KJH5001212/ad5941/discrete-potentiostat/hardware/kicad/discrete-potentiostat.kicad_pcb

## KiCad design discrete-potentiostat/hardware/kicad/discrete-potentiostat.kicad_pcb (2026-07-12, last stored version)

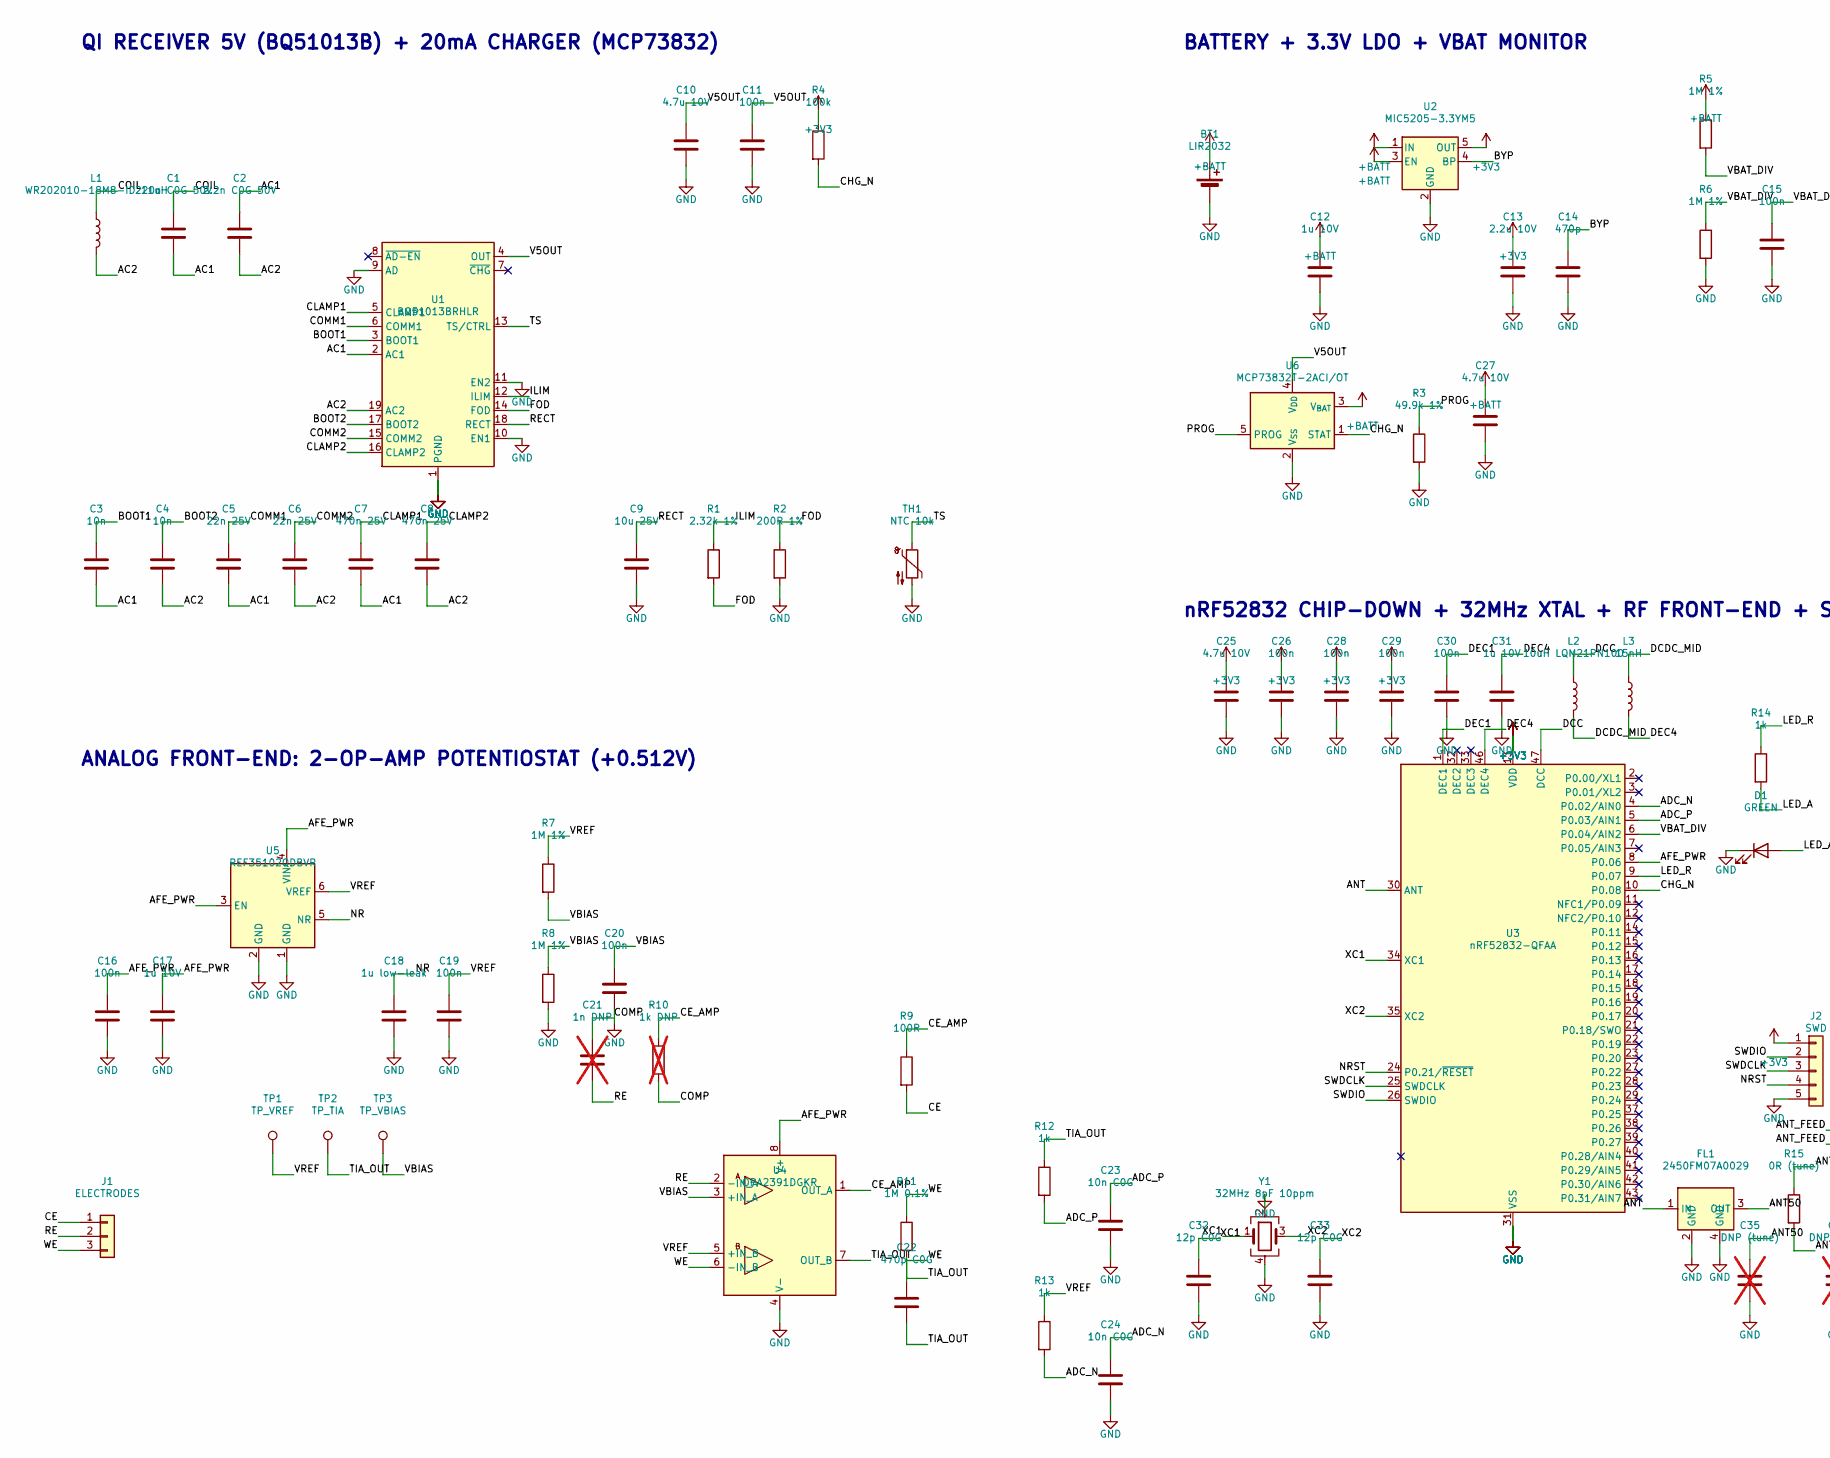
[picture p1: schematic discrete-potentiostat.kicad_sch, Discrete Potentiostat - wireless 3-electrode chronoamperome…, part in row 1, column 1]

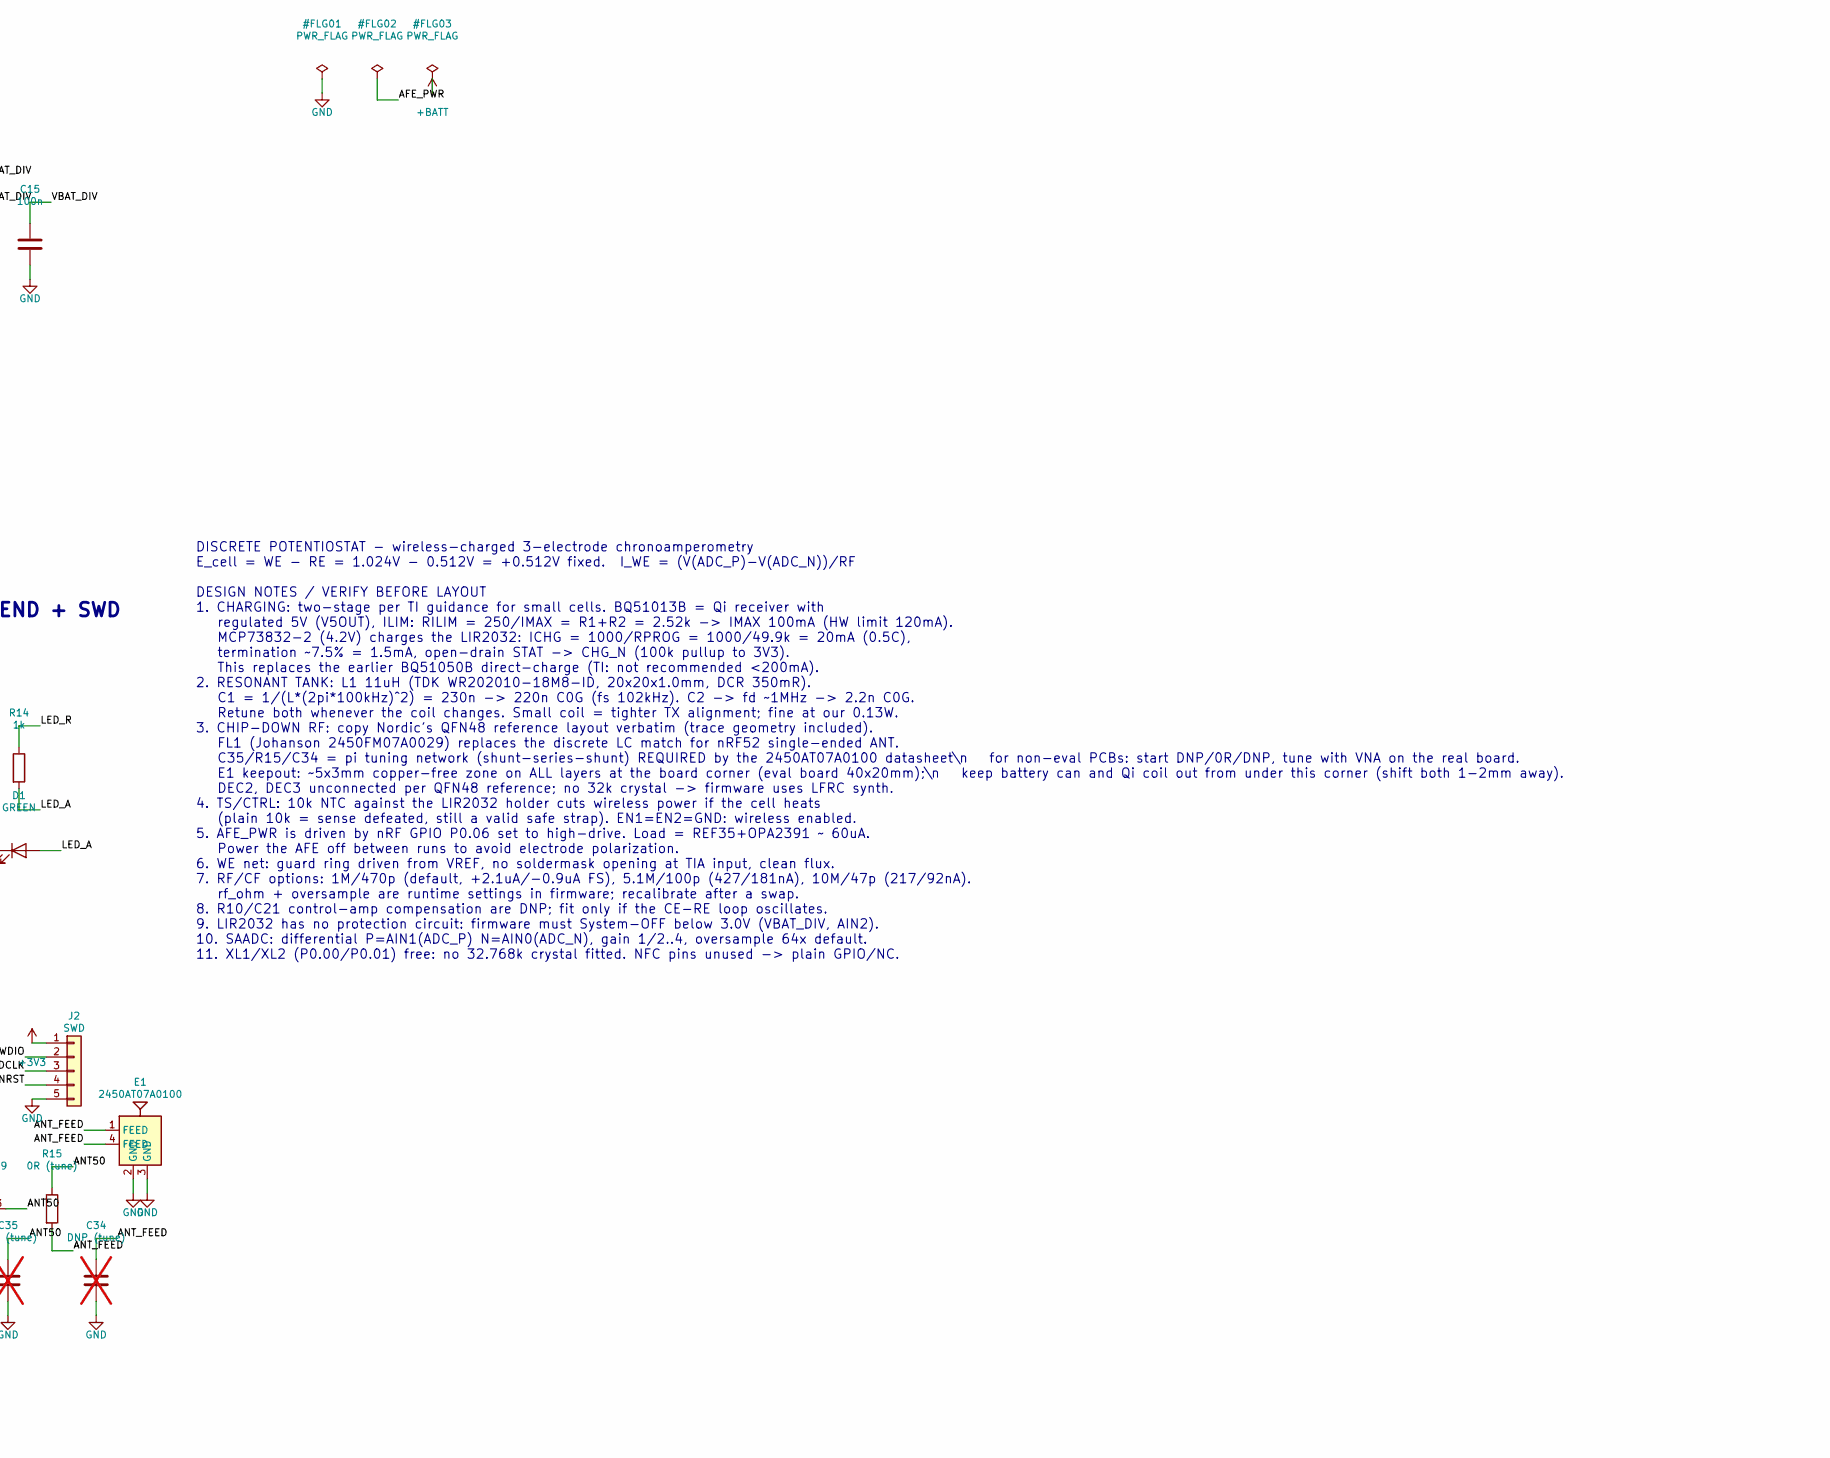
[picture p2: schematic discrete-potentiostat.kicad_sch, Discrete Potentiostat - wireless 3-electrode chronoamperome…, part in row 1, column 2]

Parts:
BT1: LIR2032; BatteryHolder_Keystone_3034_1x20mm
C1: 220n C0G 50V; C_1210_3225Metric
C2: 2.2n C0G 50V; C_0603_1608Metric
C3, C4: 10n; C_0402_1005Metric
C5, C6: 22n 25V; C_0402_1005Metric
C7, C8: 470n 25V; C_0603_1608Metric
C9: 10u 25V; C_0805_2012Metric
C10, C25, C27: 4.7u 10V; C_0603_1608Metric
C11, C15, C16, C19, C20, C26, C28, C29, C30: 100n; C_0402_1005Metric
C12, C17, C31: 1u 10V; C_0402_1005Metric
C13: 2.2u 10V; C_0603_1608Metric
C14: 470p; C_0402_1005Metric
C18: 1u low-leak; C_0603_1608Metric
C21: 1n DNP; C_0402_1005Metric; not fitted
C22: 470p C0G; C_0603_1608Metric
C23, C24: 10n C0G; C_0402_1005Metric
C32, C33: 12p C0G; C_0402_1005Metric
C34, C35: DNP (tune); C_0402_1005Metric; not fitted
D1: GREEN; LED_0603_1608Metric
E1: 2450AT07A0100; Johanson_2450AT07A0100
FL1: 2450FM07A0029; Johanson_0402_4pin
J1: ELECTRODES; SolderPads_1x03_D1.0mm
J2: SWD; SolderPads_1x05_D1.0mm
L1: WR202010-18M8-ID 11uH; TDK_WR202010
L2: 10uH LQM21PN100; L_0805_2012Metric
L3: 15nH; L_0402_1005Metric
R1: 2.32k 1%; R_0402_1005Metric
R2: 200R 1%; R_0402_1005Metric
R3: 49.9k 1%; R_0402_1005Metric
R4: 100k; R_0402_1005Metric
R5, R6, R7, R8: 1M 1%; R_0402_1005Metric
R9: 100R; R_0402_1005Metric
R10: 1k DNP; R_0402_1005Metric; not fitted
R11: 1M 0.1%; R_0603_1608Metric
R12, R13, R14: 1k; R_0402_1005Metric
R15: 0R (tune); R_0402_1005Metric
TH1: NTC 10k; R_0402_1005Metric
TP1: TP_VREF; TestPoint_Pad_D1.5mm
TP2: TP_TIA; TestPoint_Pad_D1.5mm
TP3: TP_VBIAS; TestPoint_Pad_D1.5mm
U1: BQ51013BRHLR; Texas_VQFN-RHL-20
U2: MIC5205-3.3YM5; SOT-23-5
U3: nRF52832-QFAA; QFN-48-1EP_6x6mm_P0.4mm_EP4.6x4.6mm
U4: OPA2391DGKR; VSSOP-8_3.0x3.0mm_P0.65mm
U5: REF35102QDBVR; SOT-23-6
U6: MCP73832T-2ACI/OT; SOT-23-5
Y1: 32MHz 8pF 10ppm; Crystal_SMD_3225-4Pin_3.2x2.5mm

Connections:
+3V3: C13.1, C25.1, C26.1, C28.1, C29.1, J2.1, R4.1, U2.5 (OUT), U3.13 (VDD), U3.36 (VDD), U3.48 (VDD)
+BATT: BT1.1 (+), C12.1, C27.1, R5.1, U2.1 (IN), U2.3 (EN), U6.3 (V_{BAT})
AC1: C1.2, C2.1, C3.2, C5.2, C7.2, U1.2 (AC1)
AC2: C2.2, C4.2, C6.2, C8.2, L1.2, U1.19 (AC2)
ADC_N: C24.1, R13.2, U3.4 (P0.02/AIN0)
ADC_P: C23.1, R12.2, U3.5 (P0.03/AIN1)
AFE_PWR: C16.1, C17.1, U3.8 (P0.06), U4.8 (V+), U5.3 (EN), U5.4 (VIN)
ANT: FL1.1 (IN), U3.30 (ANT)
ANT50: C35.1, FL1.3 (OUT), R15.1
ANT_FEED: C34.1, E1.1 (FEED), E1.4 (FEED), R15.2
BOOT1: C3.1, U1.3 (BOOT1)
BOOT2: C4.1, U1.17 (BOOT2)
BYP: C14.1, U2.4 (BP)
CE: J1.1, R9.2
CE_AMP: R9.1, R10.1, U4.1 (OUT_A)
CHG_N: R4.2, U3.10 (P0.08), U6.1 (STAT)
CLAMP1: C7.1, U1.5 (CLAMP1)
CLAMP2: C8.1, U1.16 (CLAMP2)
COIL: C1.1, L1.1
COMM1: C5.1, U1.6 (COMM1)
COMM2: C6.1, U1.15 (COMM2)
COMP: C21.1, R10.2
DCC: L2.1, U3.47 (DCC)
DCDC_MID: L2.2, L3.1
DEC1: C30.1, U3.1 (DEC1)
DEC4: C31.1, L3.2, U3.46 (DEC4)
FOD: R1.2, R2.1, U1.14 (FOD)
GND: BT1.2 (-), C9.2, C10.2, C11.2, C12.2, C13.2, C14.2, C15.2, C16.2, C17.2, C18.2, C19.2, C20.2, C23.2, C24.2, C25.2, C26.2, C27.2, C28.2, C29.2, C30.2, C31.2, C32.2, C33.2, C34.2, C35.2, D1.1 (K), E1.2 (GND), E1.3 (GND), FL1.2 (GND), FL1.4 (GND), J2.5, R2.2, R3.2, R6.2, R8.2, TH1.2, U1.1 (PGND), U1.9 (AD), U1.10 (EN1), U1.11 (EN2), U1.20 (PGND), U1.21 (PGND), U2.2 (GND), U3.31 (VSS), U3.45 (VSS), U3.49 (VSS), U4.4 (V-), U5.1 (GND), U5.2 (GND), U6.2 (V_{SS}), Y1.2, Y1.4
ILIM: R1.1, U1.12 (ILIM)
LED_A: D1.2 (A), R14.2
LED_R: R14.1, U3.9 (P0.07)
NR: C18.1, U5.5 (NR)
NRST: J2.4, U3.24 (P0.21/~RESET)
PROG: R3.1, U6.5 (PROG)
RE: C21.2, J1.2, U4.2 (-IN_A)
RECT: C9.1, U1.18 (RECT)
SWDCLK: J2.3, U3.25 (SWDCLK)
SWDIO: J2.2, U3.26 (SWDIO)
TIA_OUT: C22.2, R11.2, R12.1, TP2.1, U4.7 (OUT_B)
TS: TH1.1, U1.13 (TS/CTRL)
V5OUT: C10.1, C11.1, U1.4 (OUT), U6.4 (V_{DD})
VBAT_DIV: C15.1, R5.2, R6.1, U3.6 (P0.04/AIN2)
VBIAS: C20.1, R7.2, R8.1, TP3.1, U4.3 (+IN_A)
VREF: C19.1, R7.1, R13.1, TP1.1, U4.5 (+IN_B), U5.6 (VREF)
WE: C22.1, J1.3, R11.1, U4.6 (-IN_B)
XC1: C32.1, U3.34 (XC1), Y1.1
XC2: C33.1, U3.35 (XC2), Y1.3

Notes on the sheet:
DISCRETE POTENTIOSTAT - wireless-charged 3-electrode chronoamperometry E_cell = WE - RE = 1.024V - 0.512V = +0.512V fixed. I_WE = (V(ADC_P)-V(ADC_N))/RF DESIGN NOTES / VERIFY BEFORE LAYOUT 1. CHARGING: two-stage per TI guidance for small cells. BQ51013B = Qi receiver with regulated 5V (V5OUT), ILIM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
QI RECEIVER 5V (BQ51013B) + 20mA CHARGER (MCP73832)
BATTERY + 3.3V LDO + VBAT MONITOR
ANALOG FRONT-END: 2-OP-AMP POTENTIOSTAT (+0.512V)
nRF52832 CHIP-DOWN + 32MHz XTAL + RF FRONT-END + SWD

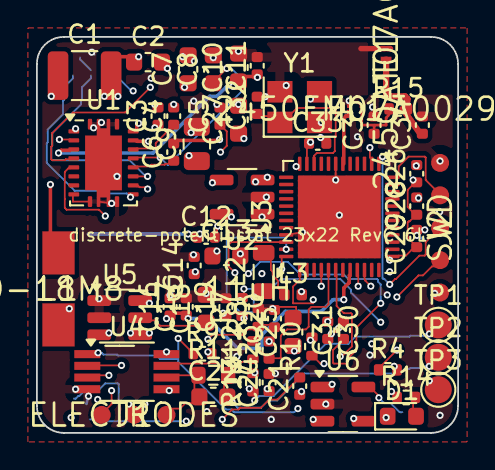
[picture p3: board discrete-potentiostat.kicad_pcb from above]

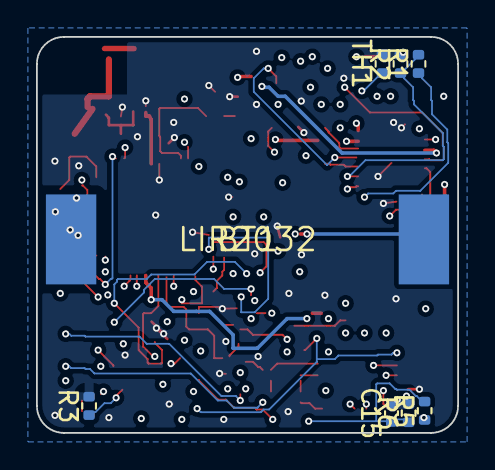
[picture p4: board discrete-potentiostat.kicad_pcb from below]

Board: 6 copper layers, 23.4 x 22.0 mm, 70 parts (8 on the bottom side), 47 nets.
