KJH5001212/ad5941/(commit log)

2026-07-10 Initial commit: AD5941 potentiostat firmware + Android app
    - firmware/: nRF52832 Zephyr chronoamperometry @ +0.5V, autorange (512k..110R),
    run modes (continuous/timed/cycle), BLE NUS JSON protocol, lossless ACK-based
    offline buffer, power-aware connection interval. Vendored ADI AD5940 lib.
    - android-app/: Kotlin controller - parameter form, current-vs-time graph,
    CSV record/export, seq-dedup + ACK lossless sync.
2026-07-10 App-controlled potentiostat: reliable BLE writes + firmware clean-up
    Android app:
    - Reliable command delivery: serialized GATT write queue + fast connection-interval
    request on connect (fixes data arriving in a delayed ~10s batch)
    - GATT cache refresh on connect, RX characteristic fallback
    - Robust percentile auto-scale for the current-vs-time plot
    - On-screen BLE diagnostics (notif/samp/tx/mtu)
    Firmware (main.c):
    - Reverted experimental start/connection-interval changes to the simple, low-power
    path; idle uses the slow (power-saving) connection interval
    - Diagnostic J-Link scripts for SWD state inspection
    Note: the board must run standalone (battery) — a connected debug probe loads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
    [main.c]
2026-07-10 Reliable repeated start/stop + responsiveness
    Firmware (ad5941_pstat/src/main.c):
    - meas_thread re-inits the AFE only when a light ADIID re-read shows it dead,
    instead of an unconditional HWReset every start (avoids re-settle latency and
    brown-out from repeated resets, while still recovering a dead AFE on start).
    - Constant fast BLE interval (idle = fast 30-50ms). The 1.5s idle interval made
    the next start's command/status slow (1.3-3s) and risked idle supervision
    timeout disconnects (status=8).
    - Boot-time AFE init retry (5x).
    App (EmgPle52):
    - userStopping guard: a stale run status right after Stop no longer flips the
    button back to Stop (the 2nd Start was actually sending stop)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
    [main.c]
2026-07-10 Add discrete-potentiostat design: OPA2391 dual-amp CA device with Qi charging
    New folder for the miniature 3-electrode chronoamperometry device built
    without the AD5941: OPA2391 (control amp + TIA), REF35102 1.024V reference,
    nRF52832 SAADC differential measurement, MIC5205-3.3, BQ51050B Qi receiver
    charging a LIR2032 coin cell.
    - README: part roles and signal chain
    - hardware/design.md: bias network (+0.4995V), TIA sizing, SAADC gain
    ranging, charge-current/TS setup, power budget, protection
    - hardware/bom.md: full BOM including precision passives
    - firmware-plan.md: port plan reusing existing BLE/buffering firmware
    Claude-Session: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
2026-07-10 Simplify bias to 1:1 divider (+0.512V), justify RF=1M + oversampling for 1nA
    - Bias: exact 0.5V not required, so use matched 1.00M/1.00M divider ->
    E = +0.512V fixed; 1% resistors suffice
    - Add RF trade-off analysis (1M + 64x oversampling vs 10M): both meet the
    1nA resolution requirement, 1M chosen for uA-range coverage; keep 10M
    swap footprint for sensors confirmed under ~200nA
    - Firmware plan: clarify the measurement core is a from-scratch rewrite
    (nRF SAADC measures directly; no AD5941 SPI code survives), only the
    BLE/buffering/protocol layers carry over
    Claude-Session: https://claude.ai/code/session_01GUNJUwfGKqvkZFmTaLQRu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
2026-07-10 Firmware plan: make RF value and oversampling runtime-configurable
    RF/CF are swappable passives, so the firmware must not hardcode them:
    rf_ohm and oversample become NVM-backed settings changeable over BLE
    config. Swapping RF then only needs soldering + config + one dummy-cell
    calibration, no reflash.
    Claude-Session: https://claude.ai/code/session_01GUNJUwfGKqvkZFmTaLQRu3
2026-07-10 Add verified KiCad schematic for the discrete potentiostat
    Complete single-sheet KiCad 7 schematic (symbols embedded, opens without
    extra libraries) covering all four blocks: BQ51050B Qi receiver/charger,
    LIR2032 + MIC5205 power, OPA2391+REF35102 AFE, MDBT42Q nRF52832 module.
    Accuracy work:
    - BQ51050BRHL and MIC5205 pin maps taken from the official KiCad library;
    OPA2391 (DGK) and REF35 (DBV) pinouts confirmed against datasheets
    - MDBT42Q 41-pad symbol: pads 1-21/37-41 web-verified, 22-36 reconstructed;
    every pad actually used in the design is a verified one
    - Charge current network corrected: no ISET pin on BQ51050B -- IBULK =
    314/RILIM via ILIM/FOD (15.4k+200R = 20mA), TERM 2.4k = 1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
    [discrete-potentiostat.kicad_sch]
2026-07-10 Replace BQ51050B direct-charge with BQ51013B + MCP73832 two-stage charging
    Resolves the coin-cell charging risk: TI states BQ5105xB does not regulate
    well below ~200mA, unsuitable for a 40mAh LIR2032. New chain follows TI's
    guidance (Qi receiver -> 5V rail -> dedicated low-current charger), using
    hand-solderable packages instead of the WCSP-only BQ51003/BQ25100 combo:
    - BQ51013BRHLR: Qi WPC v1.2 receiver, regulated 5V out, VQFN-20. Pin map
    is the verified BQ51050BRHL family symbol with the two differing pins
    confirmed against the datasheet (4 OUT, 10 EN1). EN1=EN2=GND enables
    wireless; ILIM RILIM=250/IMAX -> 2.52k = 100mA; NTC stays on TS/CTRL.
    - MCP73832T-2ACI/OT (official KiCad symb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
    [discrete-potentiostat.kicad_sch]
2026-07-10 Fix module part number: MDBT42Q-512KV2 (no 1MV2 variant exists for nRF52832)
    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
    [discrete-potentiostat.kicad_sch]
2026-07-10 Add module-vs-chipdown size/cost review: keep MDBT42Q
    Final device size is pinned by the Qi coil (26.3mm) and LIR2032 (20mm),
    not the MCU: chip-down saves ~50mm2 (4% of the 28mm disc PCB) and shrinks
    the enclosure by zero. Per-unit saving ~$1 vs $13-25k RF/cert NRE puts
    break-even at ~15-25k units. Includes a placement plan for the 28mm puck.
    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
2026-07-10 Swap Qi coil to 760308101214 (19mm/26uH): smaller AND cheaper
    The 26.3mm coil was a part-selection artifact, not a requirement — the
    original sizing logic (device bounded by the battery) is restored. The
    19mm WE-WPCC receiver coil costs less (~$7 vs ~$11), shrinks the PCB
    from ~28mm to ~23mm disc, and our 0.13W charge load easily tolerates the
    reduced coupling. Resonant caps retuned: C1 56n->100n, C2 560p->1n C0G.
    Schematic regenerated, netlist re-verified (PASS); size/cost review
    updated to the battery-bounded premise.
    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
    [discrete-potentiostat.kicad_sch]
2026-07-10 Swap Qi coil to TDK WR202010-18M8-ID (20x20x1.0mm, 11uH, ~$3.6)
    Cheapest verified candidate (half the 19mm Wurth) with the same footprint
    class as the battery. Square outline: 22x22mm rounded-square puck instead
    of a round disc (20x20 diagonal is 28.3mm). Resonant caps retuned for
    11uH: C1 220nF C0G (fs 102kHz), C2 2.2nF C0G (fd ~1MHz). Schematic
    regenerated, netlist verified (PASS).
    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
    [discrete-potentiostat.kicad_sch]
2026-07-10 Switch MCU to chip-down nRF52832-QFAA per user decision
    Module certification inheritance is moot (intentional-radiator cert is
    budgeted anyway), so the design drops MDBT42Q for the bare chip:
    - nRF52832-QFAA on the verified official KiCad symbol (48+EP pin map)
    - 32MHz crystal (CL 8pF) + 12pF loads; no 32k crystal -> LFRC synth
    - RF front-end: Johanson 2450FM07A0029 (nRF52-QFN-specific matched LPF,
    replaces discrete LC guesswork) -> 0R/DNP tee tuning slots ->
    2450AT18B0100001E chip antenna
    - Nordic QFN48 reference decoupling: DEC1 100n, DEC4 1u, DEC2/DEC3 NC,
    VDD 100n x3 + 4.7u bulk, DCC->DEC4 via 10uH+15nH (LDO-safe if unused)
    - Same GPIO functions remapped to chip pins (AIN0/1/2 = 4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
    [discrete-potentiostat.kicad_sch]
2026-07-11 Redraw REF35102 and OPA2391 symbols per user's preferred style
    - REF35102QDBVR: VIN on top, EN left, VREF/NR right, GND pins 1/2 on the
    bottom (same verified pin numbers, new geometry)
    - OPA2391DGKR: single-box dual op amp (A/B triangles inside, inputs left,
    outputs right, V+ top pin 8, V- bottom pin 4) replacing the three-unit
    LM2904-style symbol; one U4 instance carries all 8 pins
    Netlist unchanged and re-verified: 47 nets PASS.
    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
    [discrete-potentiostat.kicad_sch]
2026-07-11 Swap chip antenna to Johanson 2450AT07A0100 (0402 micro)
    Smallest Johanson 2.4GHz antenna (1.0x0.5x0.37mm). Datasheet ground
    keepout must be followed exactly; the existing R15/C34 tee slots handle
    on-board tuning. Netlist re-verified (47 nets PASS).
    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
    [discrete-potentiostat.kicad_sch]
2026-07-11 Complete antenna tee tuning network (series-shunt-series per Johanson)
    Adds R16 (0R) after the C34 shunt slot so the full tee recommended by
    Johanson is available for on-board antenna tuning. Radio-side matching
    needs no discrete LC: FL1 (2450FM07A0029) is the complete impedance
    match + harmonic LPF for the nRF52832 ANT output. Netlist PASS.
    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
    [discrete-potentiostat.kicad_sch]
2026-07-11 Antenna tuning: switch tee to pi (shunt-series-shunt) per 2450AT07A0100 datasheet
    The 0402 micro antenna's datasheet states non-eval PCBs will require a
    pi network for proper resonance (eval board alone gets away with 0R).
    Slots: C35 (DNP) - R15 (0R) - C34 (DNP). Also documents the keepout:
    ~5x3mm copper-free zone on all layers at the board corner; battery can
    and Qi coil must stay out from under it. Netlist PASS.
    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
    [discrete-potentiostat.kicad_sch]
2026-07-11 Add PCB layout: 24x22mm 4-layer, placement complete and verified
    Generated with the pcbnew API from the schematic netlist (all 70
    footprints, 77 nets assigned). Verified zero courtyard overlaps and zero
    board-edge violations via generator/check_pcb.py after an automated
    legalization pass.
    - Floorplan: Qi charger top-left (coil lead pads on left edge), RF corner
    top-right with the 5x3mm all-layer antenna keepout (rule area: no pours
    no vias, feed track allowed), nRF52832+crystal right-center, AFE bottom
    left with electrode header, MCP73832/LED/SWD bottom-right, tab-welded
    LIR2032 pads centered on the back
    - RF feed pre-routed: ANT -> 2450FM07A0029 -> pi slots -> chip antenna
    - GND po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
    [discrete-potentiostat.kicad_pcb, discrete-potentiostat.kicad_sch]
2026-07-11 Auto-route PCB: GND planes stitched, ~90% of signals routed, rules set
    Custom A* grid router (generator/route_pcb.py) over F.Cu/B.Cu with via
    moves, rip-up-and-reroute, long-net bottom-layer bias, and a RESUME mode
    that preserves existing copper and routes only unconnected endpoints.
    GND handled by 4-layer pours + shared stitching vias; RF feed untouched.
    Board design rules aligned to the routed geometry (0.09 min track/clear,
    0.4/0.2 via -> within JLC 4-layer capability), which reduces real DRC
    electrical findings to: 39 unconnected pads (~20 links, clustered at the
    charger cap bank and the nRF south-west flank), 12 clearance, 3 hole.
    Full report in hardware/kicad/drc-report.txt; interacti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
    [discrete-potentiostat.kicad_pcb]
2026-07-11 6-layer PCB + solder-pad connectors: auto-routing reaches ~92%
    Per user decisions: (1) J1/J2 pin headers replaced with 1.0mm round
    solder pads (1.8mm pitch) for direct wire soldering - also removes THT
    barrels from inner layers; (2) board upgraded 4 -> 6 layers
    (L1 sig/RF, L2 GND, L3/L4 routing, L5 GND, L6 sig+battery pads).
    Router upgraded to 4 routing layers with through-vias, DRC-driven todo
    override for RESUME runs, self-rip protection for large nets, and design
    rules baked into generation (0.09/0.09, via 0.4/0.2). Result: unrouted
    links 20 (4-layer) -> 8 (6-layer); 7 clearance items; finish guide in the
    README (KiCad push-and-shove, ~30min). DRC report refreshed.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
    [discrete-potentiostat.kicad_pcb, discrete-potentiostat.kicad_sch]
2026-07-11 Swap op amp to LPV802 (nanopower) per user request
    LPV802DGKR: 320nA/ch, 0.1pA input bias, 8kHz GBW, VSSOP-8 — same package
    and standard dual pinout as the OPA2391 it replaces, so the PCB keeps its
    routing (value updated in place). AFE rail drops to ~2uA total.
    Trade-off documented: +/-3.5mV max offset -> +/-3.5nA fixed TIA offset at
    RF=1M, removed by the existing zero-calibration step; pin-compatible
    LPV812 (+/-0.3mV) noted as the precision upgrade. Netlist re-verified.
    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
    [discrete-potentiostat.kicad_pcb, discrete-potentiostat.kicad_sch]
2026-07-11 Sync PCB generator scripts (26x24 double-sided) + doc size updates
    - gen_pcb.py: 26x24mm 6-layer, double-sided placement (ICs top, passives
    on back ring outside the LIR2032 battery zone), relative output paths
    - route_pcb.py: 4 routing layers (F/In2/In3/B), pad-core inset fix,
    RESUME mode with todo_override.json, rip-up victim filter
    - new: final_fix.py (bridge stray DRC-unconnected pads), route_loop.sh
    (DRC -> todo -> RESUME convergence loop), check_pcb.py battery-zone check
    - docs: board size finalized at 26x24mm (routability margin, user-approved)
    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
2026-07-11 Regenerate 26x24 double-sided PCB placement (routing in progress)
    The previously routed board file was accidentally overwritten by a DRC
    report; regenerated from gen_pcb.py (placement + zones + keepout + RF
    pre-route). Full auto-route re-run follows in the next commit.
    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
    [discrete-potentiostat.kicad_pcb]
2026-07-11 WIP: re-route pass for last 3 links at BQ51013B corner
    Ripped RECT/V5OUT/FOD/TS corridor blockers; router re-running with
    CLAMP2/BOOT2/COMM2 prioritized. Final routed board follows.
    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
    [discrete-potentiostat.kicad_pcb]
2026-07-11 PCB fully auto-routed: 0 unconnected, 0 copper DRC violations
    - Re-route with net priority cracked the BQ51013B QFN corner: ripped
    RECT/V5OUT/FOD/TS corridor blockers, routed CLAMP2/BOOT2/COMM2 first,
    re-routed the ripped nets after (route_pcb.py PRIORITY env)
    - GND cleanup: stitched orphan pads (U1.9/C32/R2/C23/C24) with vias,
    stitched isolated zone islands, sub-0.7mm2 slivers auto-removed
    - RF feed re-routed with clearance-validated paths: ANT (U3.30->FL1)
    approaches pad from south clear of GND pads; ANT50 runs south around
    C35; ANT_FEED rounds C34 east into the chip antenna
    - C1 moved +0.22/+0.46mm off the rounded board corner (was outside the
    edge-clearance arc); connectivity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
    [discrete-potentiostat.kicad_pcb]
2026-07-11 Shrink board to 23.4x22mm (RevC, -17.5%); 4-layer ruled out
    Size floor analysis: width bound by LIR2032 tab pads (+/-9.8mm + pad +
    edge), height by the O21 cell zone -> 23.4x22 is the practical minimum
    without changing the battery/tab structure.
    - RevC placement: ICs on top; back reduced to 4 corner pockets (R1/R2/
    TH1, R3, R5/R6/C15); J2 SWD pads + TP1-3 moved to the front right
    column (clears the battery, easier soldering); DCDC inductors L2/L3
    relocated next to U3.46/47 (fixed the persistent DCC/DEC4 congestion);
    C30 rotated 180deg so DEC1 faces the open channel
    - Routing: auto-route + priority/rip convergence to 4 links, then
    validated hand paths (close4.py): DCC via-in-pad U3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
    [discrete-potentiostat.kicad_pcb]
2026-07-11 Firmware for the discrete board: nRF52832 SAADC measurement engine
    New app under discrete-potentiostat/firmware/ replacing the AD5941 SPI
    path with direct SAADC measurement, per firmware-plan.md. The BLE
    protocol stays wire-compatible with the existing Android app.
    - meas.c: differential SAADC (AIN1 TIA_OUT vs AIN0 VREF 1.024V), 3-step
    gain table {4, 1, 1/2} (FS +/-150nA .. +/-2.1uA @1M), HW oversampling
    (1..256, runtime), 40us acquisition, recalibration on gain change;
    AFE_PWR gpio (high-drive), VBAT divider channel, /CHG input, LED
    - main.c: same thread/pacing/autorange structure as the AD5941 build
    (time-paced output at rate_hz, 85%/18% hysteresis, settle discard,
    continuous/ti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
2026-07-12 Fix E1 antenna to datasheet-true 4-terminal land pattern (GND connected)
    Johanson 2450AT07A0100 datasheet (36S0021A Rev 4.1) defines 4 terminals:
    1/4 = Feed, 2/3 = GND. Previous footprint was a wrong 2-pad guess with
    the GND end floating.
    - gen_pcb.py: 4-pad footprint (0.3x0.25 pads, rows +-0.3 along L,
    columns +-0.175 across W per eval-board land pattern); E1 moved to
    (19.4, 0.95) rot 270 - vertical edge mount, GND row toward top edge;
    parametric feed bridge to R15.2 and 0.3mm GND strip into left F pour
    - gen_sch.py: custom 4-pin antenna symbol (1/4 ANT_FEED, 2/3 GND);
    netlist check PASS (47 nets)
    - Board file: live surgery applied (new E1 + feed bridge + GND strip,
    old 2-pad E1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
    [discrete-potentiostat.kicad_pcb, discrete-potentiostat.kicad_sch]
2026-07-12 Retarget firmware to user schematic pinmap + Qi pad detection
    Pin map changes (user-drawn schematic, 2026-07-12):
    - SAADC differential swapped: AIN0 = TIA_OUT (+), AIN1 = VREF (-)
    - AFE power (AVDD direct GPIO feed) moved P0.06 -> P0.07 high-drive;
    schematic requirement: remove always-on DVDD->AVDD link (R7)
    - New Qi pad sense on P0.05/AIN3 (MCP73832_VDD 1M:1M divider):
    meas_qi_mv()/meas_qi_present(), status JSON gains "qi" field
    (chg = actually charging via STAT, qi = on charging pad)
    - LED now optional on P0.06 (unpopulated by default, harmless)
    - LDO regulator mode (DCC pin unconnected on this board) - removed
    DCDC overlay override
    - README/headers updated with final pin table and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
    [main.c]
2026-07-12 Move AFE power (AVDD feed) pin P0.07 -> P0.12
    Any plain GPIO works for the ~2uA AVDD feed; P0.12 chosen for
    schematic/layout convenience. P0.07 returns to the free-pin pool.
    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
2026-07-12 Sync README AVDD pin references to P0.12
    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
2026-07-12 Move AFE power (AVDD feed) pin to P0.26 per user schematic rev2
    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
2026-07-12 Default rf_ohm 1M -> 2M to match user board TIA feedback (R9 = 2M)
    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
2026-07-12 Document user-board design review and final parameters
    - user-board-review.md: confirmed pin map, power topology (charge
    always-on / switch-gated system / GPIO-gated AFE), resonance and
    charge-current values for the 760308101214 coil, passive size and
    voltage-rating rules (which caps cannot be 0402 and why), app-side
    battery gauge guidance, and remaining tasks
    - user-board-schematic.pdf: reviewed final schematic (rev4)
    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
2026-07-13 Move discrete-potentiostat project to its own repository
    The miniaturized wireless-charging potentiostat is a separate design
    from the AD5941-based device, so it now lives in
    https://github.com/KJH5001212/miniaturize_no5941 (full folder history
    preserved via git subtree split).
    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
    [discrete-potentiostat.kicad_pcb, discrete-potentiostat.kicad_sch]
2026-07-16 Accurate current + full-range auto-calibration
    Firmware (main.c, cmd.c/h, ad5940lib):
    - Closed-loop bias trim: self-measure Vzero-Vbias pins via ADC each boot and
    correct the 12-bit LPDAC code until the cell bias converges to a true 500 mV
    (the LPDAC transfer was +23% off nominal -> cell saw 614 mV).
    - Per-range RTIA trims measured against a 5.1M 1% reference cell at true 500 mV
    (98.04 nA): autorange accuracy verified to 0.2%.
    - On-demand RCAL auto-cal ({cmd:cal}, idle only; removed from boot):
    gate = 6-run 1k spread <10%; per-range 2-run agreement then averaged apply.
    Large ranges (512k~32k) guard = 3% repeat + physical-trim +-8% window
    (temperature tracking allowed, systematic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
    [ad5940.c, cmd.c, cmd.h, main.c]
2026-07-16 Mains-hum rejection: enable 50/60 Hz notch + trimmed-mean windows
    The 5.1M high-impedance node picked up mains bursts that leaked into two
    adjacent 100 ms averaging windows as complementary outlier pairs (+-90 nA,
    mean-preserving). Two fixes:
    - Enable the SINC2 50/60 Hz notch filter (BpNotch was bypassing it).
    - Trimmed mean per output sample: drop the min and max SINC2 reading in each
    window (>=6 samples) to reject single-sample spikes.
    Measured on the 5.1M reference cell: std 24.5 -> 2.5 nA, outliers gone,
    mean unchanged (97.8 nA vs 98.04 theoretical).
    [main.c]
